mfacton/rc-controller/README.md

# rc-controller

## General use STM32 based 2.4GHz rf transciever
Some inspiration from [DIY Arduino RC Transmitter](https://howtomechatronics.com/projects/diy-arduino-rc-transmitter/)
