mfacton/rc-controller/pcb/bom/README.md

# Bill of Materials

[Joystick](https://www.amazon.com/EEEKit-Replacement-Joystick-Thumbstick-Controller/dp/B0BDKRQ141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)

[Joystick Caps](https://www.amazon.com/eMagTech-Thumbsticks-Compatible-Replacement-Accessories/dp/B0CDFKDMD7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)

[Rotary Encoders](https://www.amazon.com/Encoder-Digital-Potentiometer-Compatible-Arduino/dp/B09KNC1J6H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)

[OLED](https://www.amazon.com/MakerFocus-Display-SSD1306-3-3V-5V-Arduino/dp/B079BN2J8V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)

[Toggle Switch](https://www.amazon.com/Gadgeter-125VAC-Position-Terminal-Latching/dp/B01JU6KBH6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,garden,262&sr=1-30-spons&psc=1&spLa=ZW5jcnlwdGVkUXVhbGlmaWVyPUEyWkRWMzZYQ1QzWEU4JmVuY3J5cHRlZElkPUExMDM5MTA4MVJIUVZZVkJXSzJPQiZlbmNyeXB0ZWRBZElkPUEwMDk1NzI3MlpEMEE3RzBSOTlaSyZ3aWRnZXROYW1lPXNwX2J0ZiZhY3Rpb249Y2xpY2tSZWRpcmVjdCZkb05vdExvZ0NsaWNrPXRydWU=&linkCode=sl1&tag=howto045-20&linkId=0d8e848cfc46369c8098dc28432ba5b4&language=en_US)

[nrf24L01+PA+LNA](https://www.amazon.com/ACEIRMC-Transceiver-Antistatic-ArduinoIDE-Compatible/dp/B092ZNYLYZ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)

[Switches](https://www.amazon.com/BOJACK-Pushbutton-Switches-Momentary-Assortment/dp/B07ZBHXBZ4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)

[Angled Switches](https://www.amazon.com/uxcell-Momentary-Tactile-Button-Switch/dp/B008DS13P2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)

[Battery Holders](https://www.amazon.com/Battery-Plastic-Storage-YOUCHENG-Connect/dp/B08LW24XND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)

[Batteries](https://www.18650batterystore.com/products/samsung-25r-18650)
