mfacton/rc-controller/pcb/rc-controller.kicad_pcb

## KiCad design pcb/rc-controller.kicad_pcb (2024-05-02)

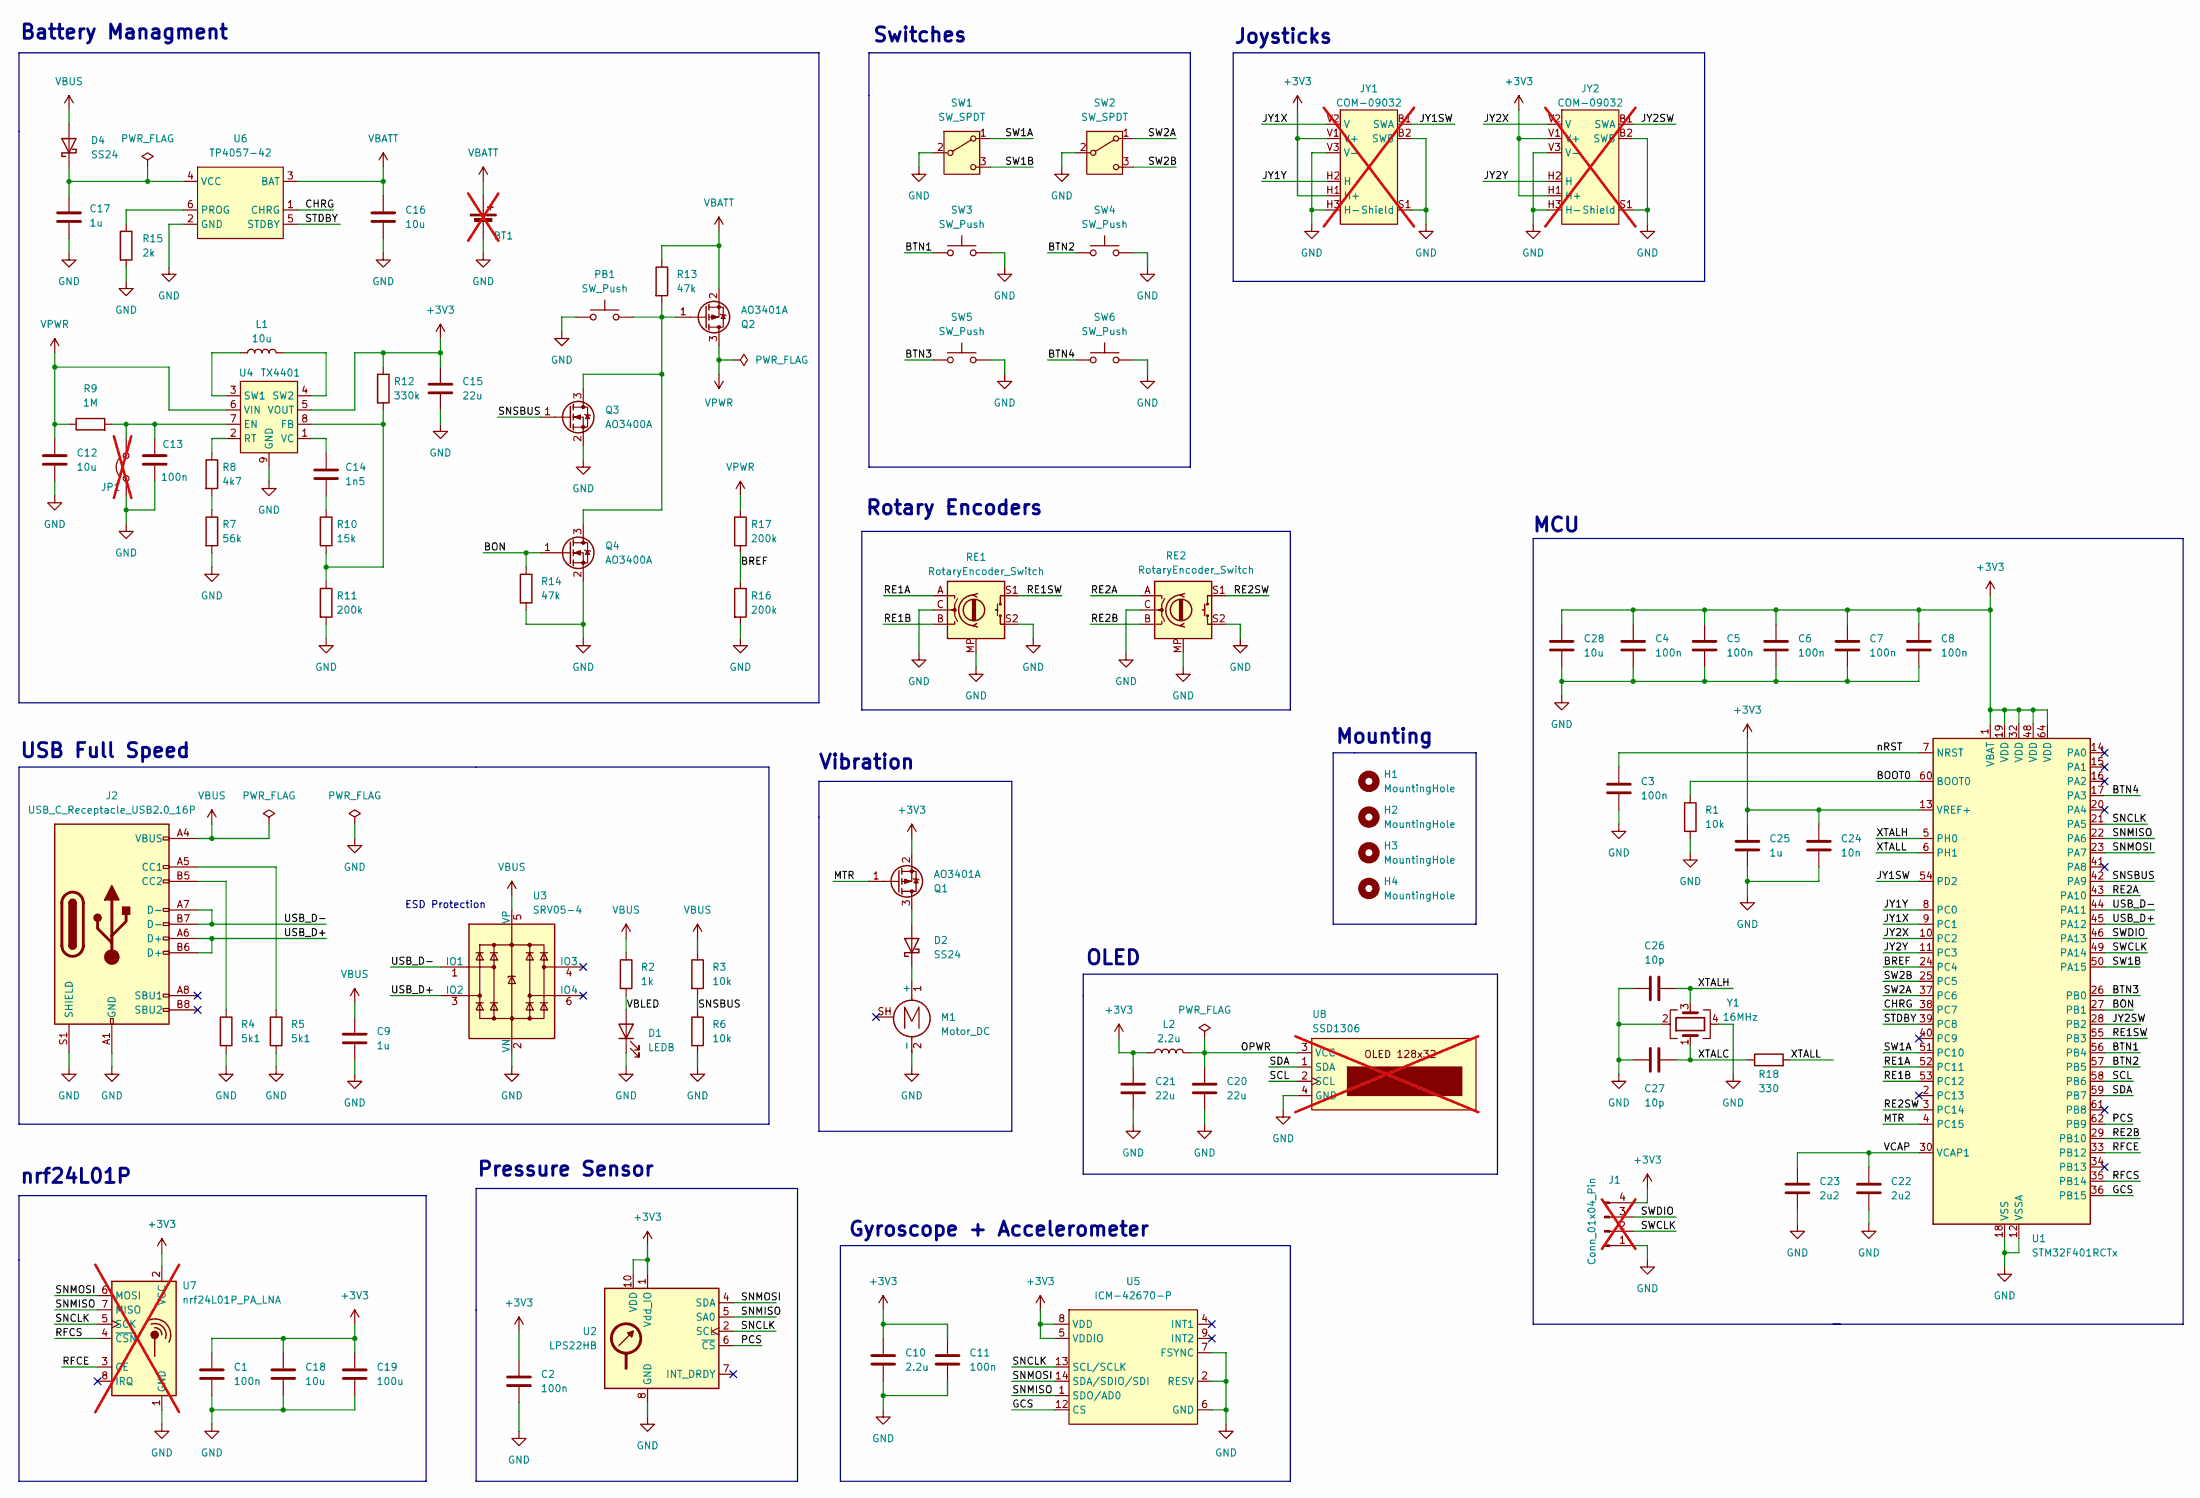
[picture p1: schematic rc-controller.kicad_sch]

Parts:
BT1: Battery_Cell; PinHeader_1x02_P2.54mm_Vertical; not fitted
C1, C2, C3, C4, C5, C6, C7, C8, C11, C13: 100n; C_0402_1005Metric
C9, C17, C25: 1u; C_0402_1005Metric
C10: 2.2u; C_0603_1608Metric
C12: 10u; C_0603_1608Metric; LCSC C19702
C14: 1n5; C_0603_1608Metric; LCSC C1595
C15, C20, C21: 22u; C_0603_1608Metric
C16, C18: 10u; C_0603_1608Metric
C19: 100u; C_1206_3216Metric
C22, C23: 2u2; C_0402_1005Metric
C24: 10n; C_0402_1005Metric
C26, C27: 10p; C_0402_1005Metric
C28: 10u; C_0402_1005Metric
D1: LEDB; LED_0603_1608Metric
D2, D4: SS24; D_SMA; LCSC C7420362
H1, H2, H3, H4: MountingHole; MountingHole_3.2mm_M3
J1: Conn_01x04_Pin; PinHeader_1x04_P2.54mm_Horizontal; not fitted
J2: USB_C_Receptacle_USB2.0_16P; USB_C_Receptacle_GCT_USB4105-xx-A_16P_TopMnt_Horizontal; LCSC C165948
JP1: Jumper_2_Open; SolderJumper-2_P1.3mm_Open_RoundedPad1.0x1.5mm; not fitted
JY1, JY2: COM-09032; not fitted
L1: 10u; L_1206_3216Metric; LCSC C395029
L2: 2.2u; L_0805_2012Metric; LCSC C1043
M1: Motor_DC; Vybronics_VZ30C1T8219732L; LCSC C2894731
PB1: SW_Push; SW_PUSH_6mm_H13mm; LCSC C2834892
Q1, Q2: AO3401A; SOT-23
Q3, Q4: AO3400A; SOT-23
R1, R3, R6: 10k; R_0402_1005Metric
R2: 1k; R_0402_1005Metric
R4, R5: 5k1; R_0402_1005Metric
R7: 56k; R_0402_1005Metric
R8: 4k7; R_0402_1005Metric
R9: 1M; R_0402_1005Metric; LCSC C26083
R10: 15k; R_0402_1005Metric
R11, R16, R17: 200k; R_0402_1005Metric
R12: 330k; R_0402_1005Metric; LCSC C25778
R13, R14: 47k; R_0402_1005Metric
R15: 2k; R_0402_1005Metric
R18: 330; R_0402_1005Metric
RE1, RE2: RotaryEncoder_Switch; RotaryEncoder_Alps_EC11E-Switch_Vertical_H20mm; LCSC C202365
SW1, SW2: SW_SPDT; 2MS; LCSC C908281
SW3, SW4, SW5, SW6: SW_Push; SW_PUSH_6mm_H13mm; LCSC C2834892
U1: STM32F401RCTx; LQFP-64_10x10mm_P0.5mm; LCSC C74524
U2: LPS22HB; ST_HLGA-10_2x2mm_P0.5mm_LayoutBorder3x2y; LCSC C94049
U3: SRV05-4; SOT-23-6; LCSC C7420376
U4: TX4401; HSOP-8-1EP_3.9x4.9mm_P1.27mm_EP2.41x3.1mm; LCSC C448642
U5: ICM-42670-P; LGA-14_3x2.5mm_P0.5mm_LayoutBorder3x4y
U6: TP4057-42; SOT-23-6
U7: nrf24L01P_PA_LNA; PinHeader_2x04_P2.54mm_Vertical; not fitted
U8: SSD1306; PinHeader_1x04_P2.54mm_Vertical; not fitted
Y1: 16MHz; Crystal_SMD_3225-4Pin_3.2x2.5mm

Connections:
+3V3: C1.1, C2.1, C4.1, C5.1, C6.1, C7.1, C8.1, C10.1, C11.1, C15.1, C18.1, C19.1, C21.1, C24.1, C25.1, C28.1, J1.4, JY1.H1 (H+), JY1.V1 (V+), JY2.H1 (H+), JY2.V1 (V+), L2.1, Q1.2 (S), R12.1, U1.1 (VBAT), U1.13 (VREF+), U1.19 (VDD), U1.32 (VDD), U1.48 (VDD), U1.64 (VDD), U2.1 (Vdd_IO), U2.10 (VDD), U4.5 (VOUT), U5.5 (VDDIO), U5.8 (VDD), U7.2 (VCC)
/BON: Q4.1 (G), R14.1, U1.27 (PB1)
/BOOT0: R1.1, U1.60 (BOOT0)
/BREF: R16.1, R17.2, U1.24 (PC4)
/BTN1: SW3.1, U1.56 (PB4)
/BTN2: SW4.1, U1.57 (PB5)
/BTN3: SW5.1, U1.26 (PB0)
/BTN4: SW6.1, U1.17 (PA3)
/CHRG: U1.38 (PC7), U6.1 (CHRG)
/GCS: U1.36 (PB15), U5.12 (CS)
/JY1SW: JY1.B1 (SWA), U1.54 (PD2)
/JY1X: JY1.V2 (V), U1.9 (PC1)
/JY1Y: JY1.H2 (H), U1.8 (PC0)
/JY2SW: JY2.B1 (SWA), U1.28 (PB2)
/JY2X: JY2.V2 (V), U1.10 (PC2)
/JY2Y: JY2.H2 (H), U1.11 (PC3)
/MTR: Q1.1 (G), U1.4 (PC15)
/OPWR: C20.1, L2.2, U8.3 (VCC)
/PCS: U1.62 (PB9), U2.6 (~CS)
/RE1A: RE1.A, U1.52 (PC11)
/RE1B: RE1.B, U1.53 (PC12)
/RE1SW: RE1.S1, U1.55 (PB3)
/RE2A: RE2.A, U1.43 (PA10)
/RE2B: RE2.B, U1.29 (PB10)
/RE2SW: RE2.S1, U1.3 (PC14)
/RFCE: U1.33 (PB12), U7.3 (CE)
/RFCS: U1.35 (PB14), U7.4 (~CSN)
/SCL: U1.58 (PB6), U8.2 (SCL)
/SDA: U1.59 (PB7), U8.1 (SDA)
/SNCLK: U1.21 (PA5), U2.2 (SCL), U5.13 (SCL/SCLK), U7.5 (SCK)
/SNMISO: U1.22 (PA6), U2.5 (SA0), U5.1 (SDO/AD0), U7.7 (MISO)
/SNMOSI: U1.23 (PA7), U2.4 (SDA), U5.14 (SDA/SDIO/SDI), U7.6 (MOSI)
/SNSBUS: Q3.1 (G), R3.2, R6.1, U1.42 (PA9)
/STDBY: U1.39 (PC8), U6.5 (STDBY)
/SW1A: SW1.1 (A), U1.51 (PC10)
/SW1B: SW1.3 (C), U1.50 (PA15)
/SW2A: SW2.1 (A), U1.37 (PC6)
/SW2B: SW2.3 (C), U1.25 (PC5)
/SWCLK: J1.2, U1.49 (PA14)
/SWDIO: J1.3, U1.46 (PA13)
/USB_D+: J2.A6 (D+), J2.B6 (D+), U1.45 (PA12), U3.3 (IO2)
/USB_D-: J2.A7 (D-), J2.B7 (D-), U1.44 (PA11), U3.1 (IO1)
/VBLED: D1.2 (A), R2.2
/VCAP: C22.1, C23.1, U1.30 (VCAP1)
/XTALC: C27.2, R18.1, Y1.1
/XTALH: C26.2, U1.5 (PH0), Y1.3
/XTALL: R18.2, U1.6 (PH1)
/nRST: C3.1, U1.7 (NRST)
GND: BT1.2 (-), C1.2, C2.2, C3.2, C4.2, C5.2, C6.2, C7.2, C8.2, C9.2, C10.2, C11.2, C12.2, C13.2, C15.2, C16.2, C17.2, C18.2, C19.2, C20.2, C21.2, C22.2, C23.2, C24.2, C25.2, C26.1, C27.1, C28.2, D1.1 (K), J1.1, J2.A1 (GND), J2.A12 (GND), J2.B1 (GND), J2.B12 (GND), J2.S1 (SHIELD), JP1.1 (A), JY1.B2 (SWB), JY1.H3 (H-), JY1.S1 (Shield), JY1.V3 (V-), JY2.B2 (SWB), JY2.H3 (H-), JY2.S1 (Shield), JY2.V3 (V-), M1.2 (-), PB1.1, Q3.2 (S), Q4.2 (S), R1.2, R4.2, R5.2, R6.2, R7.2, R11.2, R14.2, R15.2, R16.2, RE1.C, RE1.MP, RE1.S2, RE2.C, RE2.MP, RE2.S2, SW1.2 (B), SW2.2 (B), SW3.2, SW4.2, SW5.2, SW6.2, U1.12 (VSSA), U1.18 (VSS), U1.31 (VSS), U1.47 (VSS), U1.63 (VSS), U2.3 (GND), U2.8 (GND), U2.9 (GND), U3.2 (VN), U4.9 (GND), U5.2 (RESV), U5.3 (RESV), U5.6 (GND), U5.7 (FSYNC), U5.10 (RESV), U5.11 (RESV), U6.2 (GND), U7.1 (GND), U8.4 (GND), Y1.2, Y1.4
unnamed: C14.1, R10.1
unnamed: D2.2 (A), Q1.3 (D)
unnamed: D2.1 (K), M1.1 (+)
unnamed: C17.1, D4.1 (K), U6.4 (VCC)
unnamed: J2.A5 (CC1), R5.1
unnamed: J2.B5 (CC2), R4.1
unnamed: C13.1, JP1.2 (B), R9.2, U4.7 (EN)
unnamed: PB1.2, Q2.1 (G), Q3.3 (D), Q4.3 (D), R13.2
unnamed: R7.1, R8.2
unnamed: R10.2, R11.1, R12.2, U4.8 (FB)
unnamed: R8.1, U4.2 (RT)
unnamed: L1.1, U4.3 (SW1)
unnamed: L1.2, U4.4 (SW2)
unnamed: C14.2, U4.1 (VC)
unnamed: R15.1, U6.6 (PROG)
VBATT: BT1.1 (+), C16.1, Q2.2 (S), R13.1, U6.3 (BAT)
VBUS: C9.1, D4.2 (A), J2.A4 (VBUS), J2.A9 (VBUS), J2.B4 (VBUS), J2.B9 (VBUS), R2.1, R3.1, U3.5 (VP)
VPWR: C12.1, Q2.3 (D), R9.1, R17.1, U4.6 (VIN)

Notes on the sheet:
Mounting
Joysticks
Battery Managment
OLED
Vibration
Pressure Sensor
MCU
nrf24L01P
USB Full Speed
Rotary Encoders
Gyroscope + Accelerometer
Switches
ESD Protection

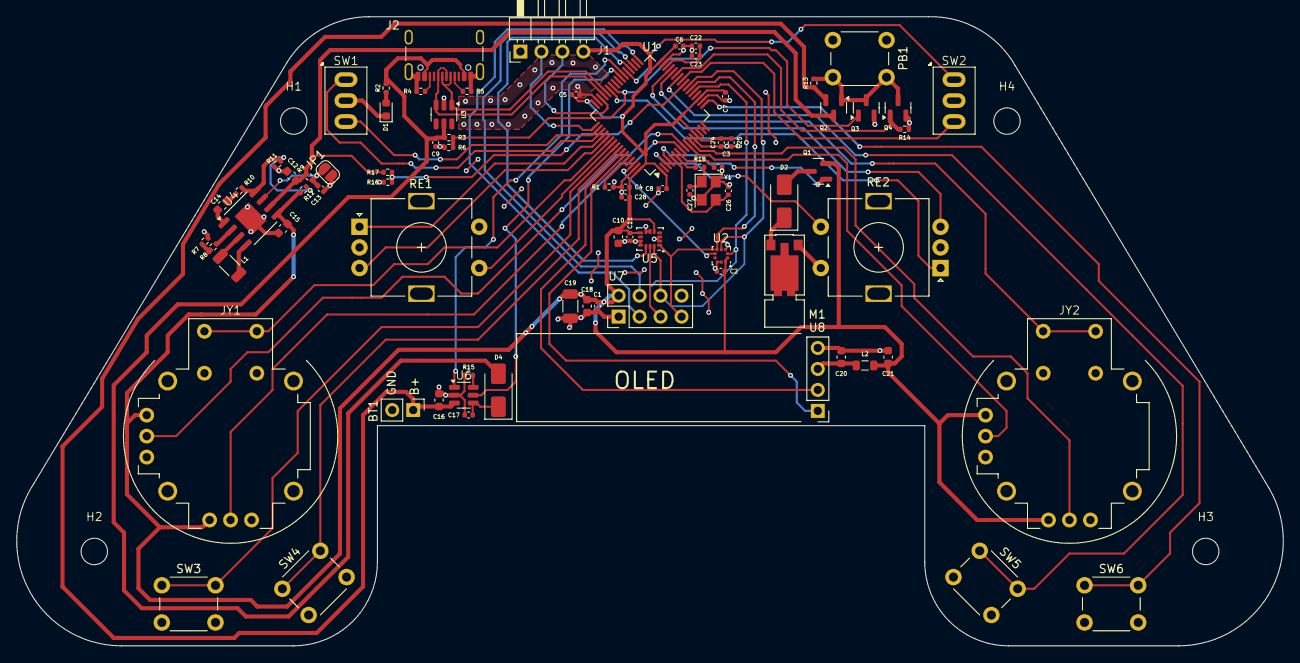
[picture p2: board rc-controller.kicad_pcb from above]

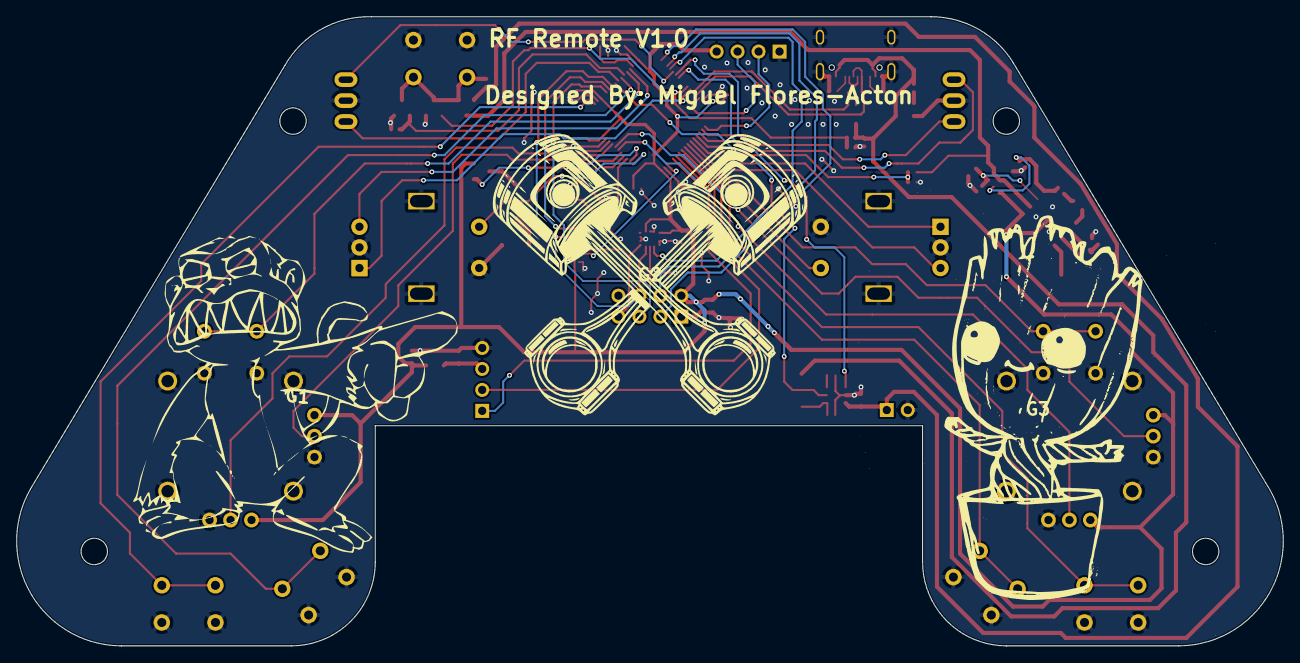
[picture p3: board rc-controller.kicad_pcb from below]

Board: 2 copper layers, 153.4 x 76.2 mm, 87 parts (3 on the bottom side), 67 nets.

Other parts of the board:
G1: Monkey; LOGO
G2: Engine; LOGO
G3: GROOT; LOGO
