mfacton/rc-controller/firmware/BoatController/BoatController.ioc

Mcu.UserName=STM32F401RCTx
PA10.GPIO_Label=RE2A
PA10.Signal=GPIO_Input
PA11.Signal=USB_OTG_FS_DM
PA12.Signal=USB_OTG_FS_DP
PA13.Signal=SYS_JTMS-SWDIO
PA14.Signal=SYS_JTCK-SWCLK
PA15.GPIO_Label=SW1B
PA15.Signal=GPIO_Input
PA3.GPIO_Label=BTN4
PA3.Signal=GPIO_Input
PA5.Signal=SPI1_SCK
PA6.Signal=SPI1_MISO
PA7.Signal=SPI1_MOSI
PA9.Signal=USB_OTG_FS_VBUS
PB0.GPIO_Label=BTN3
PB0.Signal=GPIO_Input
PB1.GPIO_Label=BTNON
PB1.Signal=GPIO_Output
PB10.GPIO_Label=RE2B
PB10.Signal=GPIO_Input
PB12.GPIO_Label=RFCE
PB12.Signal=GPIO_Output
PB14.GPIO_Label=RFCS
PB14.Signal=GPIO_Output
PB15.GPIO_Label=GCS
PB15.Signal=GPIO_Output
PB2.GPIO_Label=JY2SW
PB2.Signal=GPIO_Input
PB3.GPIO_Label=RE1SW
PB3.Signal=GPIO_Input
PB4.GPIO_Label=BTN1
PB4.Signal=GPIO_Input
PB5.GPIO_Label=BTN2
PB5.Signal=GPIO_Input
PB6.Signal=I2C1_SCL
PB7.Signal=I2C1_SDA
PB9.GPIO_Label=PCS
PB9.Signal=GPIO_Output
PC0.GPIO_Label=JY1Y
PC0.Signal=ADCx_IN10
PC1.GPIO_Label=JY1X
PC1.Signal=ADCx_IN11
PC10.GPIO_Label=SW1A
PC10.Signal=GPIO_Input
PC11.GPIO_Label=RE1A
PC11.Signal=GPIO_Input
PC12.GPIO_Label=RE1B
PC12.Signal=GPIO_Input
PC14-OSC32_IN.GPIO_Label=RE2SW
PC14-OSC32_IN.Signal=GPIO_Input
PC15-OSC32_OUT.GPIO_Label=MTR
PC15-OSC32_OUT.Signal=GPIO_Output
PC2.GPIO_Label=JY2X
PC2.Signal=ADCx_IN12
PC3.GPIO_Label=JY2Y
PC3.Signal=ADCx_IN13
PC4.GPIO_Label=BREF
PC4.Signal=ADCx_IN14
PC5.GPIO_Label=SW2B
PC5.Signal=GPIO_Input
PC6.GPIO_Label=SW2A
PC6.Signal=GPIO_Input
PC7.GPIO_Label=CHRG
PC7.Signal=GPIO_Input
PC8.GPIO_Label=STBY
PC8.Signal=GPIO_Input
PD2.GPIO_Label=JY1SW
PD2.Signal=GPIO_Input
