mfacton/rc-controller/(commit log)

2024-04-18 init kicad project
    [rc-controller.kicad_pcb, rc-controller.kicad_sch]
2024-04-18 Restructure project
    [rc-controller.kicad_pcb, rc-controller.kicad_sch]
2024-04-18 Add pcb bom materials
    [rc-controller.kicad_sch]
2024-04-19 Finish schematic
    [rc-controller.kicad_sch]
2024-04-19 Create STM32 project
    [rc-controller.kicad_sch]
2024-04-19 Fix gitignore for kicad autosave file
2024-04-19 Remove kicad autosave file
2024-04-20 Add crystal oscillator
    [rc-controller.kicad_sch]
2024-04-20 Configure USB
    [rc-controller.kicad_sch]
2024-04-20 Organize pin functions
    [rc-controller.kicad_sch]
2024-04-20 Assign basic footprints
    [rc-controller.kicad_sch]
2024-04-23 Finish mapping footprints
    [rc-controller.kicad_pcb, rc-controller.kicad_sch]
2024-04-24 Finish rough layout
    [rc-controller.kicad_pcb]
2024-04-25 Final placement before routing
    [rc-controller.kicad_pcb, rc-controller.kicad_sch]
2024-04-26 Add net classes
    [rc-controller.kicad_sch]
2024-04-26 Add net classes for pcb
    [rc-controller.kicad_pcb]
2024-04-26 Finish layout
    [rc-controller.kicad_pcb]
2024-04-26 Add silkscreen
    [rc-controller.kicad_pcb]
2024-04-26 Fix bom and generate fab files
    [rc-controller.kicad_pcb, rc-controller.kicad_sch]
2024-05-02 Initialize stm32 project and fix vref issue
    [rc-controller.kicad_pcb, rc-controller.kicad_sch]
2024-05-09 Remove kicad refrences
2024-05-09 Remake STM32 project
2024-05-09 Finish STM32Cube setup
2024-05-12 Kicad autosave
2024-05-14 Remove and ignore autogenerated stm32 code
